astroelectronica/AE01.07.16.044/png/AE01.07.16.044_BOTTOM.png

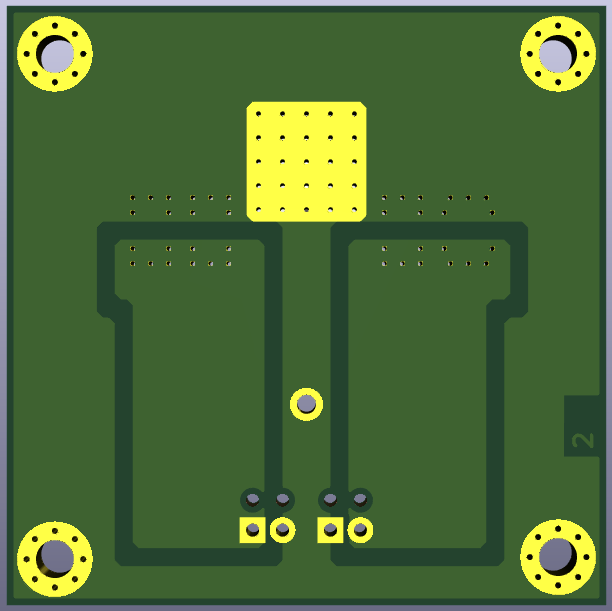
png/AE01.07.16.044_BOTTOM.png
