astroelectronica/AE01.07.16.044/png/AE01.07.16.044_TOP.png

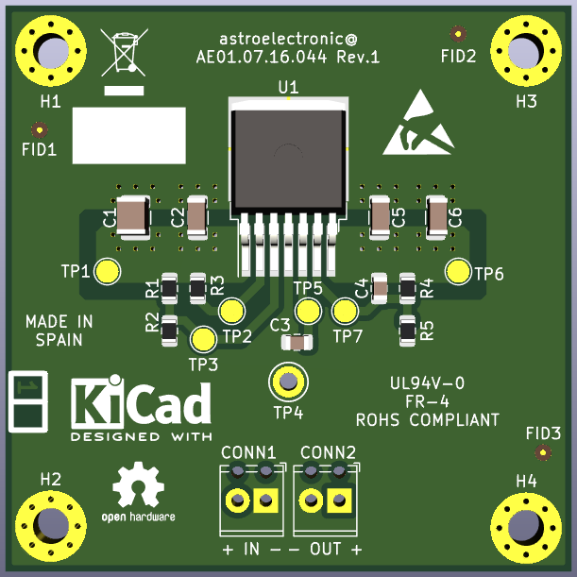
png/AE01.07.16.044_TOP.png
