astroelectronica/AE01.07.16.044/pcb/AE01.07.16.044.pdf

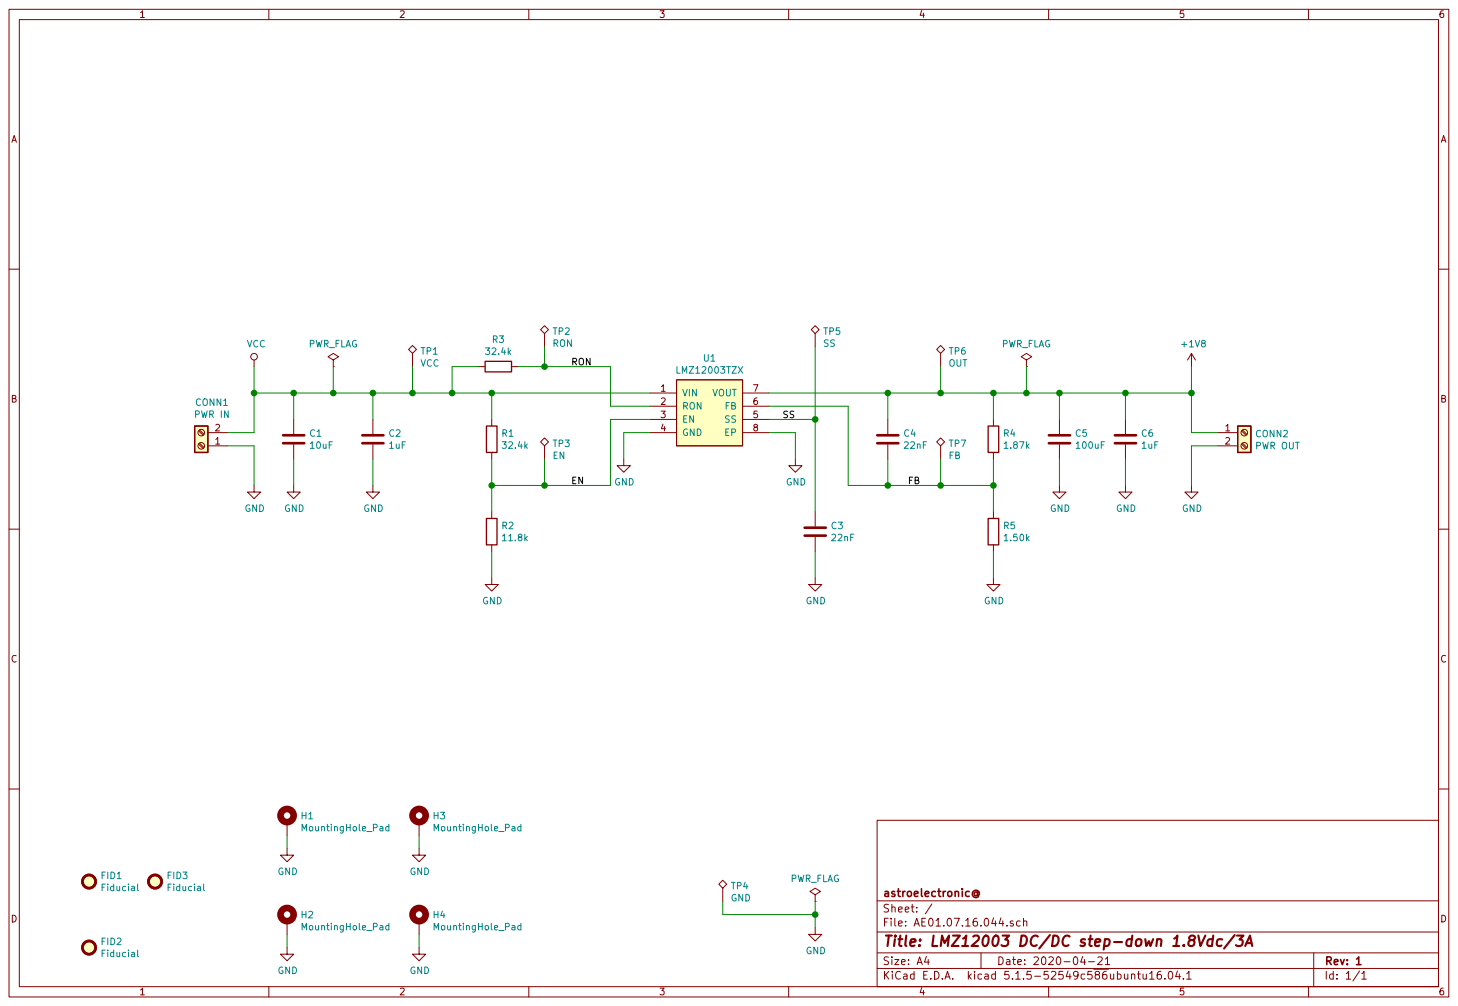
[picture p5: page 1]

File: AE01.07.16.044.sch Sheet: / astroelectronic@

Id: 1/1 Title: LMZ12003 DC/DC step-down 1.8Vdc/3A
