astroelectronica/AE01.07.16.044/pcb/fab/AE01.07.16.044-F_Mask.pdf

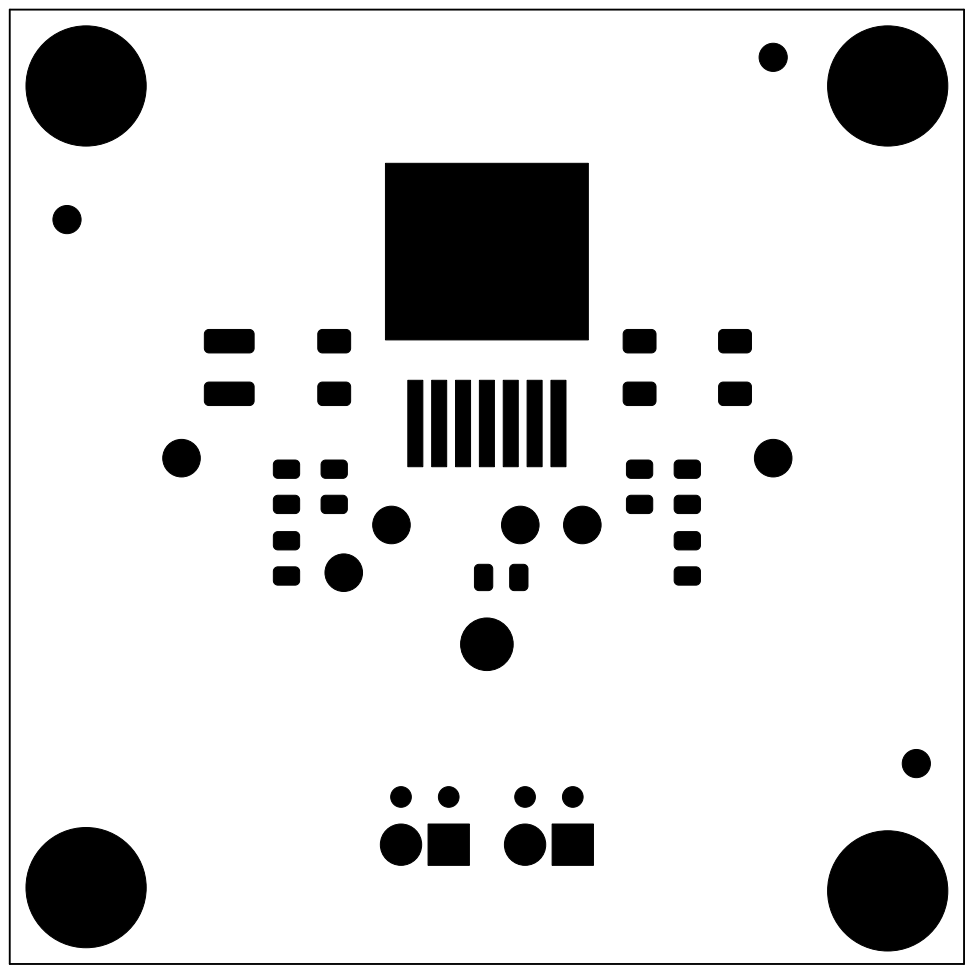
[picture p10: page 1]

Id: 1/1 Title: LMZ12003 DC/DC step-down 1.8Vdc/3A
