astroelectronica/AE01.07.16.044/simulation/sim01_transient_response/AE01.17.16.044_sim01_transient_response.pdf

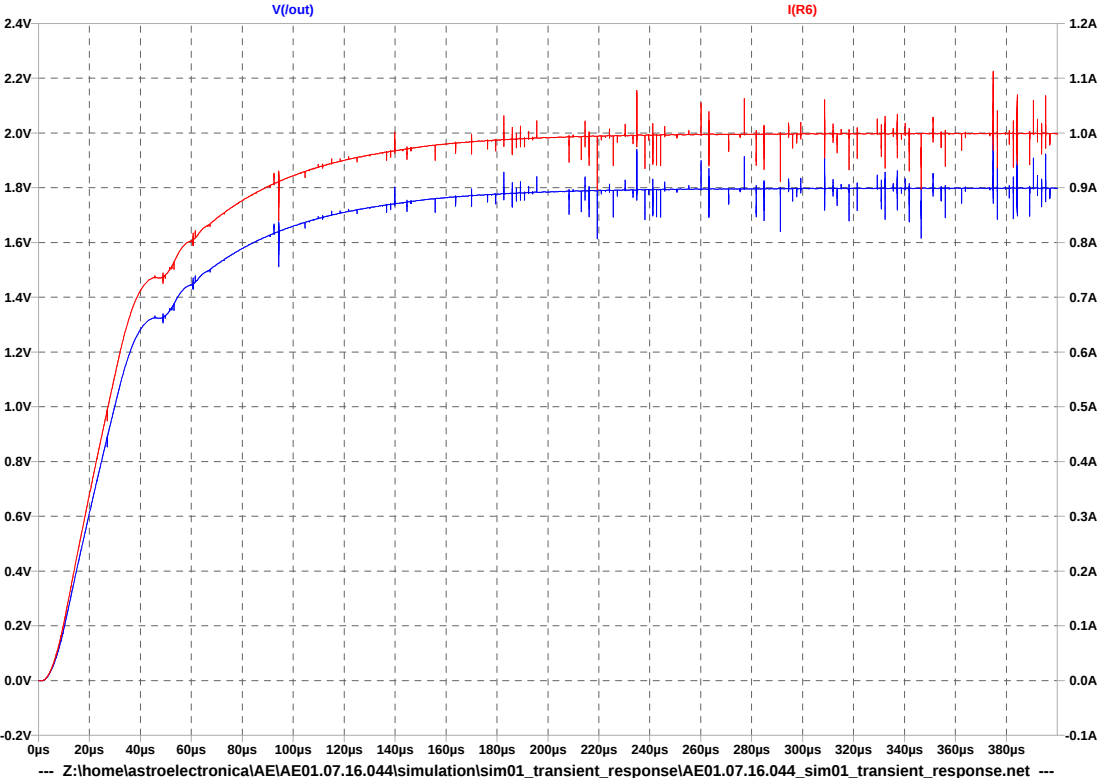
[picture p12: page 1]
V(/out)

Z:\home\astroelectronica\AE\AE01.07.16.044\simulation\sim01_transient_response\AE01.07.16.044_sim01_transient_response.net
