astroelectronica/AE01.07.16.044/pcb/AE01.07.16.044.kicad_pcb

## KiCad design pcb/AE01.07.16.044.kicad_pcb (2021-08-11)

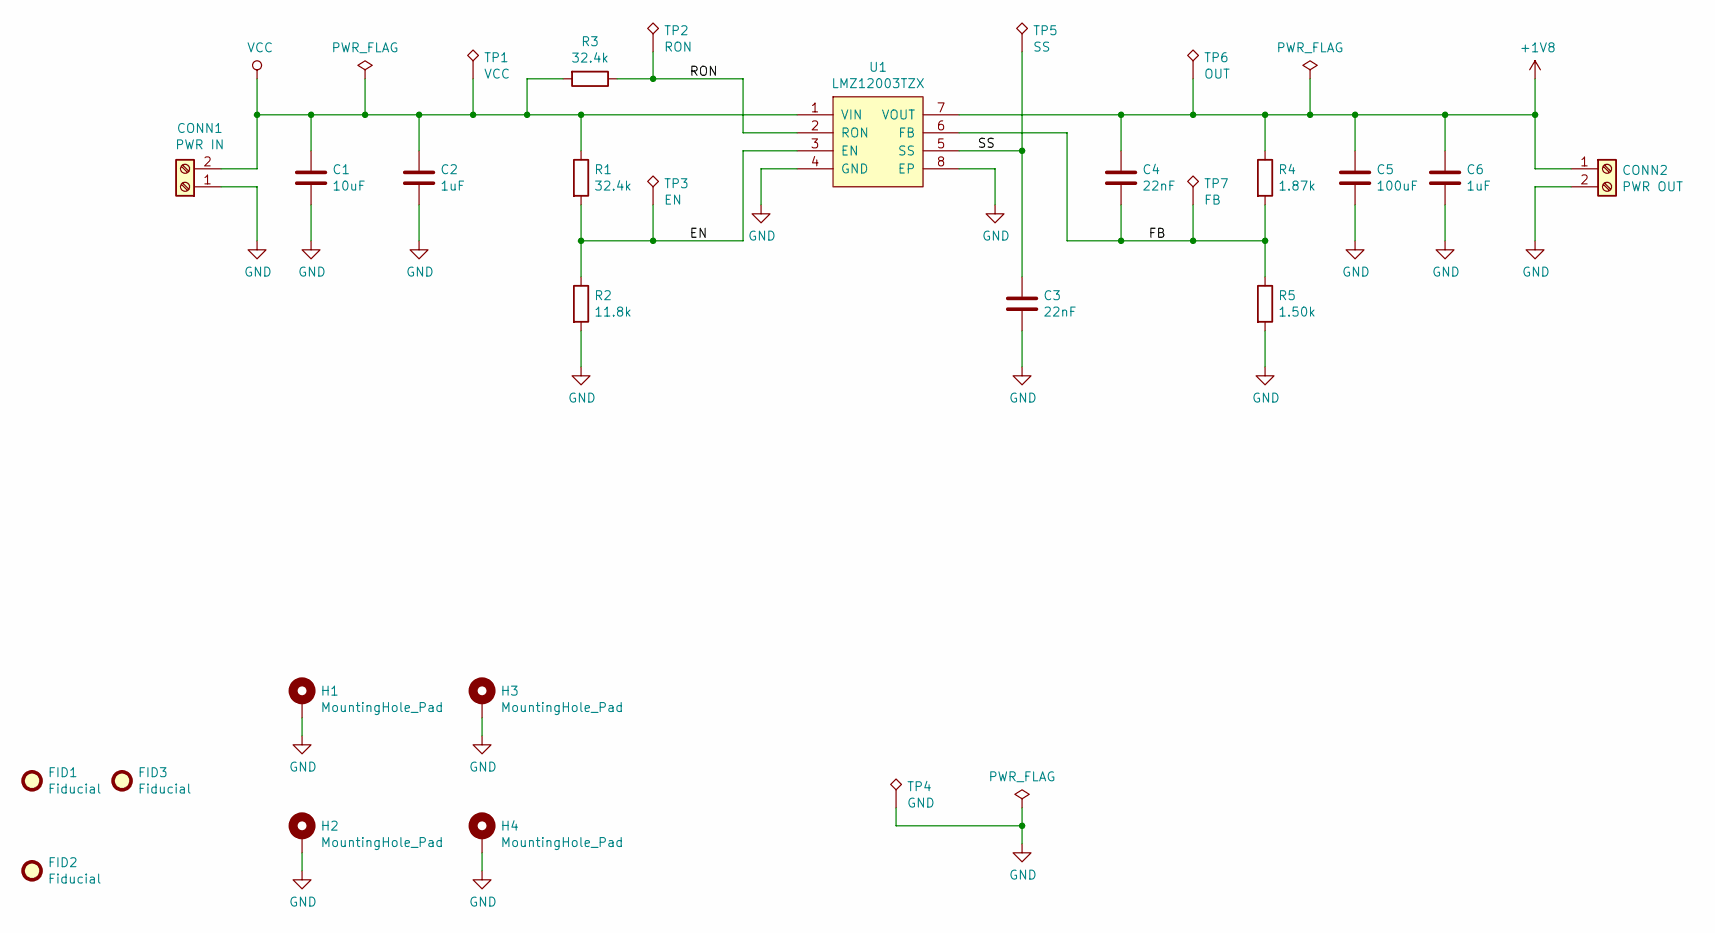
[picture p13: schematic AE01.07.16.044.sch, LMZ12003 DC/DC step-down 1.8Vdc/3A]

Parts:
C1: 10uF; C_1210_3225Metric; MPN C3225X5R1H106K250AB
C2, C6: 1uF; C_1206_3216Metric; MPN C3216X7R1H105K160AE
C3, C4: 22nF; C_0805_2012Metric; MPN C2012X7R2A223K125AE
C5: 100uF; C_1206_3216Metric; MPN C3216X5R0J107M160AB
CONN1: PWR IN; TerminalBlock_Phoenix_MPT-0,5-2-2.54_1x02_P2.54mm_Horizontal; MPN 1725656
CONN2: PWR OUT; TerminalBlock_Phoenix_MPT-0,5-2-2.54_1x02_P2.54mm_Horizontal; MPN 1725656
FID1, FID2, FID3: Fiducial; Fiducial_0.5mm_Mask1.5mm
H1, H2, H3, H4: MountingHole_Pad; MountingHole_3.2mm_M3_Pad_Via
R1, R3: 32.4k; R_0805_2012Metric; MPN RC0805FR-0732K4L
R2: 11.8k; R_0805_2012Metric; MPN RC0805FR-0711K8L
R4: 1.87k; R_0805_2012Metric; MPN RC0805FR-071K87L
R5: 1.50k; R_0805_2012Metric; MPN RC0805FR-071K5L
TP1: VCC; TestPoint_Pad_D2.0mm
TP2: RON; TestPoint_Pad_D2.0mm
TP3: EN; TestPoint_Pad_D2.0mm
TP4: GND; TestPoint_Keystone_5010-5014_Multipurpose; MPN 5011
TP5: SS; TestPoint_Pad_D2.0mm
TP6: OUT; TestPoint_Pad_D2.0mm
TP7: FB; TestPoint_Pad_D2.0mm
U1: LMZ12003TZX; TO-263-7_TabPin8; MPN LMZ12003TZX-ADJ/NOPB

Connections:
+1V8: C4.1, C5.1, C6.1, CONN2.1, R4.1, TP6.1, U1.7 (VOUT)
/EN: R1.2, R2.1, TP3.1, U1.3 (EN)
/FB: C4.2, R4.2, R5.1, TP7.1, U1.6 (FB)
/RON: R3.1, TP2.1, U1.2 (RON)
/SS: C3.1, TP5.1, U1.5 (SS)
GND: C1.2, C2.2, C3.2, C5.2, C6.2, CONN1.1, CONN2.2, H1.1, H2.1, H3.1, H4.1, R2.2, R5.2, TP4.1, U1.4 (GND), U1.8 (EP)
VCC: C1.1, C2.1, CONN1.2, R1.1, R3.2, TP1.1, U1.1 (VIN)

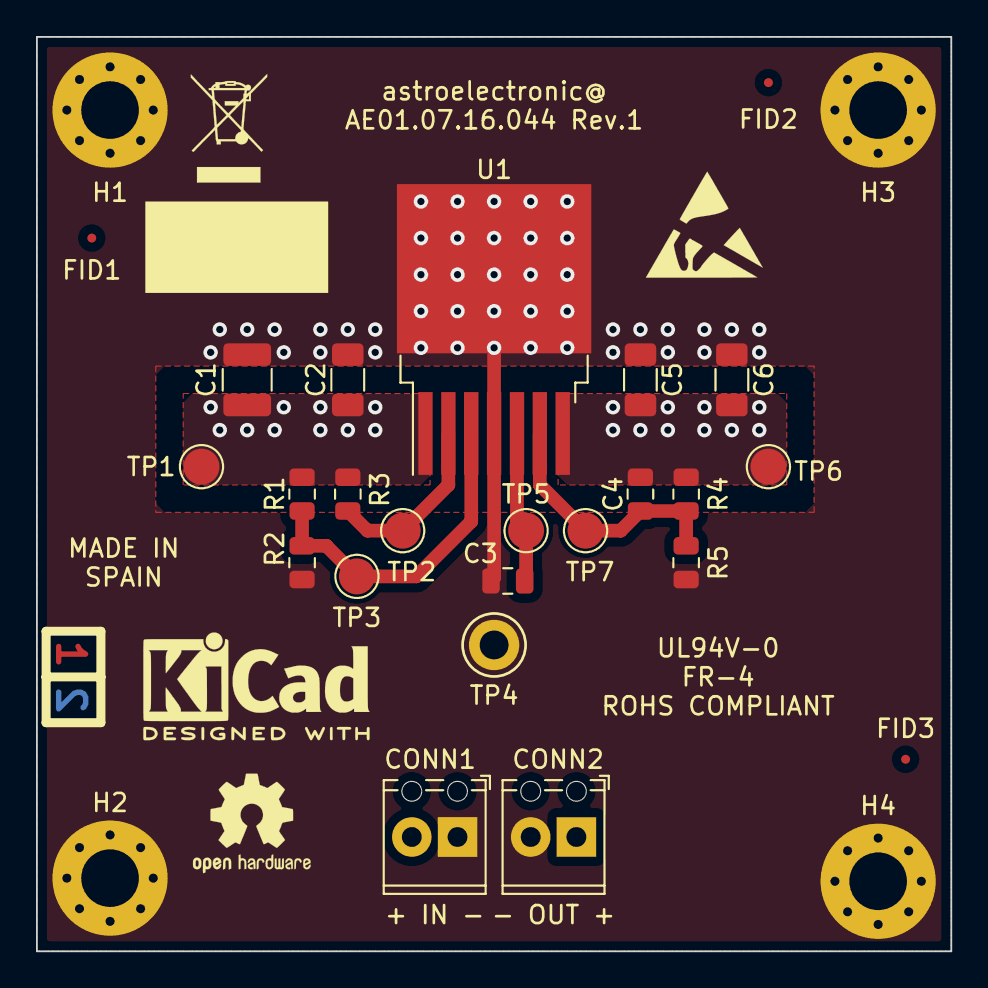
[picture p14: board AE01.07.16.044.kicad_pcb from above]

Board: 2 copper layers, 50.8 x 50.8 mm, 28 parts (0 on the bottom side), 7 nets.
